c2213/wood-bridge/docs/design-exploration.md

# 形状探索 — ダビンチアーチを維持した CP 最大化

2026-10-21 実施。構造形式はダビンチアーチのまま変えず、CP = 最大荷重 / 自重^1.5 が最大になる構成を総当たりで探した。釣り糸と厚紙は、構造に効く場合だけ使う前提にした。
計算は [scripts/explore_davinci.py](../scripts/explore_davinci.py)。FEM・照査・材料値は [構造監査](structural-audit.md) と共通。

```sh
python3 scripts/explore_davinci.py            # 全探索（約 8 分）
python3 scripts/explore_davinci.py --refine   # 上位付近の絞り込み（約 1 分）
```

## 結論

**推奨案（下路・ダビンチ改良案）: CP 1.45、破壊荷重 約 292 N（30 kgf）、重量 約 34 g、荷重/自重 約 870 倍。**
現案（CP 0.10）の約 14 倍。

| 項目 | 現案 | 推奨案 |
| --- | --- | --- |
| 縦材 | 5mm角、各リブ A2列・B1列 | **4mm角**、各リブ A2列・B1列 |
| 横材 | 3mm角 | 3mm角 |
| 交差部 | 接着のみ（接着面 15 mm²） | **両側面に厚紙ガセット**（重ね 10 mm） |
| 床版縦桁（タイ） | 5mm角 | **5×15 縦使い** |
| ハンガー | 釣り糸ナイロン3号・全節点 | 同じ |
| 床版シート | 厚紙 t=0.5 | **なし**（ルール適合の確認が必要） |
| 支配する破壊（P） | 交差部の接着せん断（28 N） | 縦桁 292 N、面内座屈 350 N、めり込み 385 N がほぼ同じ水準 |

- **形の特徴:** 縦材が 4mm角になると δ = 3.5 mm、R = 349 mm になり、縦材長は 145.8 mm（150 mm まで余裕 4.2 mm）。現案の余裕 0.4 mm の問題も解消する。
- **床版シートを載せる場合:** ケント紙 t=0.2 で CP 1.12。

## 何が効いたか

| 変更 | 効果 | 理由 |
| --- | --- | --- |
| 交差部の厚紙ガセット | 破壊荷重が約 4〜9 倍 | 弱点だった木目直交の接着面（15 mm²）を、側面どうしの重ね接着で補える |
| 床版シートをなくす | 重量 −16 g | 荷重は横桁で受けられる。シートは構造的にほぼ働いていない |
| 縦桁を 5×15 縦使い | 破壊荷重が約 3 倍（重量は +8 g） | 補強後に次の弱点になった縦桁の曲げに効く |
| 縦材を 5 → 4mm角 | 軽量化、部材長の余裕が増える | 交差部を補強すると、縦材の断面に余力が出る |
| 釣り糸ハンガー（ナイロン） | バルサ 3mm角と同等以上 | 伸びやすい糸の方が、荷重が強い縦桁へ多く回る。重さはほぼ 0 |

**材料値の感度（推奨案）:**

| 振った材料値 | CP |
| --- | --- |
| 曲げ強度 13.5〜27 MPa | 0.94〜1.71 |
| 重ね接着のせん断 0.5〜2 MPa | 1.07〜1.45 |
| めり込み 0.4〜1.0 MPa | 1.28〜1.45 |
| ヤング率 2.1〜4.3 GPa | 1.24〜1.32 |

## 探索の範囲

全探索で、ルールに適合する 2,708 案を評価した。

| 項目 | 範囲 |
| --- | --- |
| 形式 | 下路（リブ2本＋吊り床版）、上路（アーチ上面を床版とする本来のダビンチ橋＋タイ） |
| 分割数 n | 8、10、12 |
| 縦材・横材 | 3角、4角、5角、5×15 平使い |
| 列数（A/B） | 1/1、2/1、1/2、2/2、3/3 |
| 交差部 | 接着のみ、厚紙ガセット |
| ハンガー | バルサ 3mm角、ナイロン3号（全節点、載荷点のみ） |
| 床版シート | なし、ケント紙 t=0.2 |
| タイ（上路） | 3角、5角 |

絞り込みでは、縦桁（タイ）の断面（4角、5角、5×15 縦使い）と、上路の荷重受け（5×15）を加えた。
ルールは「部材長 150 mm 以下」「有効幅 80 mm 以上」「床版上の有効高さ 80 mm」を自動で判定した。

**上路（本来のダビンチ橋）の最良:** CP 1.01（P 31 N、W 9.7 g）。非常に軽いが、載荷点の横材の曲げとタイで壊れ、下路の推奨案に届かなかった。床版が曲面になる点もルール上の確認が必要。

**形式の限界:** 同じ前提（床版シートなし）のプラットトラスは CP 約 3.2。ダビンチ形式を維持する場合、推奨案はトラスの約半分の CP になる。

## 厚紙なし条件での再探索（2026-10-21、ユーザー決定を受けて）

ユーザーの決定: 推奨案の方向で採用、床版シートなし、**厚紙は使わない**、材料試験は行わない。
推奨案の性能は交差部の厚紙ガセットに依存していたため、厚紙なしの条件で再探索した（`python3 scripts/explore_davinci.py --nocard`、約 2.5 分）。

- **評価した範囲:** 下路で 496 案（ルール適合）。
  - 分割数 8/10/12。
  - 縦材は 4角・5角・5×15 平使い、横材は 3〜5角・5×15 平使い。
  - 荷重が入る節点だけ横材を 5×15 平使いにする案も含めた。
  - 列数、ハンガー、縦桁 5角/5×15 も振った。
- **自立条件の判定:** 分割数と断面の組合せによっては、自立条件と支間 500 mm を同時に満たす R が存在しない。こうした構成を除外する判定を加えた。

**最良案（採用）: 分割数 10、縦材 4mm角、横材 5mm角、各リブ A1列/B1列、ナイロン3号ハンガーを載荷節点のみ、床版シートなし、縦桁 5×15 縦使い。**
CP 0.42、破壊荷重 約 59 N、重量 約 27 g、荷重/自重 約 220 倍。

| 比較 | CP |
| --- | --- |
| 旧案（ダビンチ、厚紙床版、交差部は接着のみ） | 0.08〜0.10 |
| **採用案（厚紙なし）** | **0.42** |
| 分割数 8 で最良の厚紙なし案 | 0.26 |
| 厚紙ガセットありの推奨案（不採用） | 1.45 |

- **分割数 10 が最良になる理由:** 交差部の接着面積（縦材の幅 × 横材の幅）を、部材長 150 mm 以下の範囲で最も大きくできる。横材 5mm角にでき、接着面は 20 mm²（分割数 8 の 3mm角では 12 mm²）。代わりにアーチが高くなる（クラウン約 21 cm）。
- **支配する破壊:** 交差接合の接着せん断で、最も弱い交差部は節点 T3・T7（x≈120・380）。次に弱いのは、荷重が入る T4・T6。
- **材料値の感度:**
  - 交差接合のせん断強度 0.4〜1.0 MPa で、CP 0.34〜0.84。接着の出来がそのまま性能に効く。
  - ヤング率 2.1〜4.3 GPa で、CP 0.38〜0.45。
  - めり込み強度と曲げ強度は、振っても CP が変わらなかった。

## 交差部の柔らかさを考慮した再評価（2026-10-21）

ユーザーから「59 N は低すぎるのでは」と指摘があり、モデルを見直した。

- **見直した点:** これまで、交差部（縦材と横材の接着）を無限に硬いとして扱っていた。実際には、横材の繊維直角方向はころがりせん断で柔らかい。剛として扱うと交差部に力が集まり、破壊荷重を過小に評価する。
- **新しいモデル:**
  - 交差部の接線方向の剛性はころがりせん断弾性係数（G_LT/10 ≈ 13 MPa）、法線方向は E90（0.046 E）から算定した。
  - 縦桁の横倒れ座屈（横桁の位置を横方向の支点とみなす簡易式）と、アーチ分担率（ハンガーがアーチへ運ぶ荷重の割合）を加えた。
  - 追加した選択肢: A系とB系を密着させ側面で交差点を接着する案、突き出し 3 mm（横材の半幅 +0.5 mm 以上に限る）。
- 実行: `python3 scripts/explore_davinci.py --nocard --soft`（約 15 分、ルール適合 2,192 案）。

**結果**

| 案 | P | W | CP | アーチ分担 | 支配する破壊 |
| --- | --- | --- | --- | --- | --- |
| 現行案（n=10、縦4角・横5角、A1/B1、ナイロン載荷点のみ、縦桁 5×15） | 111 N | 26.9 g | 0.80 | 25% | 縦桁の横倒れ座屈 |
| CP 最大: 現行案＋A–B 側面接着＋突き出し 3 mm | 117 N | 26.7 g | 0.85 | 28% | 縦桁の横倒れ座屈 |
| 全部 5mm 角（縦5角・横5角、A–B 側面接着、突き出し 3 mm） | 130 N | 31.6 g | 0.74 | 33% | 縦桁の横倒れ座屈 |
| アーチが主に運ぶ案の最良（全 5mm 角、縦桁 5×5、A1/B1、ナイロン載荷点のみ、突き出し 3 mm） | 62 N | 23.5 g | 0.54 | 90% | B系縦材の曲げ（曲げ 97%） |

**分かったこと**

- 剛として扱った旧評価（59 N）は控えめすぎた。現行案の推定は約 110〜120 N。
- **CP が高い案ほど、荷重の大部分を縦桁（5×15）が梁として運び、アーチの分担は 25〜33%。** 釣り糸ハンガーは伸びやすく、アーチより縦桁の方が硬いため。
- **アーチに主に荷重を運ばせると、CP は最大 0.54 にとどまる。** ダビンチの縦材は 3 点曲げで働くため、梁より効率が悪い。
- **全部 5mm 角にすると、破壊荷重は上がる（約 130 N）が、重くなるため CP は下がる（0.74）。** アーチ主体の案に限ると、全部 5mm 角が最良（CP 0.54）。

## 解析の自己点検と、床版なし・2点荷重向け補強の探索（2026-10-21）

ユーザーの指示: 床版なし。ダビンチの強みを活かしつつ、2点荷重に合う補強を探す。解析に不備がないかも点検する。

### 解析の自己点検（見つけた不備と対応）

| 不備 | 影響 | 対応 |
| --- | --- | --- |
| 交差部を無限に硬く扱っていた | 交差部に力が集まり、破壊荷重を約半分に過小評価 | ころがりせん断剛性と E90 から見積もった柔らかさを導入 |
| 自立条件と支間を同時に満たせない構成を通していた | 成立しないアーチ（R が下限に張り付く）を評価していた | 成立判定を追加して除外 |
| 監査スクリプトが図面の現行設計値を参照していた | 図面を更新すると旧案の監査結果が変わる | 監査対象の寸法を監査スクリプト側に固定 |
| 同系の縦材の端を、両方とも節点から突き出していた | 実物では同じ場所に置けない | 端を突き付ける（木口どうしのピン接合）選択肢を追加 |
| 縦桁の横倒れ座屈、アーチの面外座屈を照査していなかった | 細い部材の不安定を見落とす | 簡易式で照査を追加（概算） |

- **突き付け接合の効果:** 期待した強度向上は得られなかった（1 つの横材に力が集まる）。ただし中間の節点で突き出しが不要になり、部材長の制約が緩む。そのため分割数 8 で、縦材 3角・横材 5角 の組合せが成立するようになった。
- **荷重のかけ方の影響:** 同じアーチで比べると、破壊荷重は 2点 57 N、全節点に均等分散 68 N、中央1点 23 N。2点載荷はダビンチに不利だが、強さを抑えている主因は交差部と座屈。

### 探索（`python3 scripts/explore_davinci.py --reinforce`、ルール適合 1,350 案）

- **構成:** 床版なし。アーチ（ダビンチ）とタイだけで、錘はアーチの節点またはタイから吊る。
- **補強の候補:**
  - なし
  - 鉛直材（バルサ 3角）
  - ワーレン腹材（バルサ 3角、アーチ節点とタイをジグザグに結ぶ）
  - ニールセン（釣り糸の X 字）
- **振った項目:** 分割数、断面、列数、幅（詰め／90 mm）、タイ（3角・5角）とアンカー。

| 補強 | 最良 CP | P | W | 荷重/自重 |
| --- | --- | --- | --- | --- |
| **ワーレン腹材（錘はアーチ節点から）** | **1.73** | 43 N | 8.5 g | 約 510 倍 |
| ニールセン（釣り糸、錘はタイから） | 1.45 | 16 N | 5.0 g | 約 330 倍 |
| ワーレン腹材（錘はタイから） | 1.38 | 28 N | 7.4 g | 約 380 倍 |
| 補強なし | 0.96 | 19 N | 7.4 g | 約 270 倍 |
| 鉛直材 | 0.92 | 15 N | 6.5 g | 約 240 倍 |

**最良案:**

- 構成: 分割数 8、縦材 3mm角、横材 5mm角、A系 2列・B系 2列、同系の端は突き付け、タイ 3mm角、ワーレン腹材 3mm角（8 本、75〜136 mm）、幅を詰める（約 19 mm）。
- 形: クラウン高さ 125 mm、縦材長 147.6 mm。
- 支配する破壊: 交差部の接着せん断。次いで面外座屈 56 N、面内座屈 65 N。
- 補強の効果: 同じアーチで補強なしと比べると、破壊荷重は約 4 倍（10 → 43 N）、CP は約 3 倍（0.59 → 1.73）。腹材がアーチとタイを三角形でつなぎ、2点荷重による曲げ（形と荷重の不一致）を軸力で受け持つため。

**注意:**

- 幅を詰めた案（約 19 mm）は、横倒れの照査が概算しかない。幅 60 mm で CP 1.36、90 mm で 1.17。
- 錘を吊る節点 T3/T5 は x=179.1/320.9 で、載荷点 x=175/325 から 4 mm ずれる。
- 交差部の接着強度（ころがりせん断 0.5 MPa）が性能をほぼ決める。

### 採用（2026-10-21）

ユーザーの決定: 補強付きのこの案を採用、幅は詰める、床版なし。

- **腹材の配置を変更:** 図面化（3D 配置）で、腹材を中央の面に置くとアーチの縦材と干渉することが分かった。腹材をタイと同じ両側の 2 面（z=±9）に置き、横材を 22 mm に延ばした。
- **性能の再計算:** 腹材が 2 面になり重量が約 1.2 g 増えた。最終形は P 約 44 N、W 約 9.8 g、CP 1.41（探索時の 1 面の値は 1.73）。
- 詳細は [要件定義](requirements.md) を参照。

### ダビンチの編み構造は効いているか（2026-10-21 検証）

採用案で、アーチの編み構造（A・B 系を横材で編む）が強さに貢献しているかを確かめた。

| 比較（同じタイ・同じワーレン腹材 2 面・同じ載荷） | P | W | CP |
| --- | --- | --- | --- |
| 採用案（ダビンチの編み、3mm 角 A2/B2） | 44 N | 9.8 g | 1.41 |
| 上弦材を普通の折れ線アーチに替える（3mm 角 × 2 列、節点で連続） | 43 N | 6.8 g | 2.42 |
| 上弦材を普通の折れ線アーチに替える（3mm 角 × 4 列、節点で連続） | 85 N | 9.0 g | 3.18 |
| 採用案から腹材を除く（ダビンチのアーチだけ） | 10 N | 6.9 g | 0.57 |

- **荷重を主に受け持っているのは、タイと腹材によるトラスの働き。** 腹材を除くと破壊荷重は約 1/4 になる。
- **編み構造は弱点になっている。** アーチ縦材は曲げ応力が軸応力の約 3.7 倍で、最初に壊れるのも交差部の接着。同じ量の材料を普通の折れ線アーチ（連続材）に使うと、CP は約 2.3 倍になる。
- **ダビンチの本来の利点が、この課題では効きにくい。** ダビンチの利点は、留め具なしで短い材から長い支間を組めること。この課題では接着が許され、普通のアーチも短い材（節点間約 72 mm）を接着して組めるため、その利点が性能差にならない。
- **残る価値:** 見た目、コンセプト、オリジナリティ（プレゼンと相互評価の対象）。

## 確認が必要な事項（推奨案の時点）

1. **推奨案を採用して、図面（SVG/STL）と要件定義を更新するか。**
2. **床版シートなしでルールを満たすか**（担当教員に確認）。満たさない場合はケント紙 t=0.2 を使う（CP 1.12）。
3. **載荷点と横桁の位置:** 推奨案の横桁 C3 は x=180.8 で、載荷点 x=175 から 5.8 mm ずれる。シートがない場合、載荷治具は横桁の上に直接載るため、横桁を x=175 に置いて縦桁経由でハンガーへ渡す詳細にする。
4. **製作の手間:** 厚紙ガセットは交差部 54 か所 × 2 枚で、約 110 枚になる。
5. **未検証の項目:** 横倒れ（3D）は未解析。縦桁 5×15 の継手（添え板の重ね 30 mm、両面）も実物の試験が要る。
