c2213/wood-bridge/docs/structural-audit.md

# 構造監査 — ダビンチアーチ橋（下路式タイドアーチ）案

2026-10-21 実施。対象は [docs/requirements.md](requirements.md) のベース案（コミット `767f1c7`）。
計算は [scripts/audit_fem.py](../scripts/audit_fem.py)（`python3 scripts/audit_fem.py` で再現できる）。

## 結論

- **現案（ダビンチ）は CP で高得点を狙えない。** 推定の破壊荷重は約 22〜28 N（2.3〜2.8 kgf）、荷重/自重は約 50〜65 倍で、比較した形式の中で最も低い。
- **同じルール・同じ材料なら、下路式プラットトラスの CP が最も高い。** 現案の約 15 倍（CP 1.39 対 0.08）。次が通常の（編まない）タイドアーチ（CP 0.77）。
- **床版の軽量化が最も効く。** 厚紙 t=0.5（約 16 g）は総重量の約 4 割を占める。ケント紙 t=0.2 に替えると、どの形式でも CP が約 1.5 倍になる。
- **アンカーは不要。** 床版縦桁をタイにする方が強く、重さもほぼ同じ。タイを外してアンカーにすると、どの形式でも破壊荷重が大きく下がった。

CP = 最大荷重 / 自重^1.5 は実施要領 p.4 の式。表では P [N] / W [g]^1.5 で計算しており、形式間の比較だけに使う。

## 1. 評価方法

| # | 方法 | 何を見たか |
| --- | --- | --- |
| 1 | 手計算（アーチの釣合い） | 水平力 H = M/f。FEM の検算に使った |
| 2 | 2D フレーム FEM（線形） | 部材の軸力・曲げ、交差部の接触力、ハンガー・タイの張力、たわみ。圧縮になった釣り糸は外して再計算 |
| 3 | 線形座屈固有値解析 | 面内の全体座屈荷重（Sturm 列の二分法） |
| 4 | 部材・接合の照査 | 軸力＋曲げの組合せ、面外座屈（Euler）、交差部のめり込み・接着せん断、ガセット・継手、釣り糸の破断 |
| 5 | 形式比較 | ダビンチ（5通り）、通常タイドアーチ、プラットトラス（3断面）、アンカー案、床版4種 |
| 6 | 感度分析 | 接着強度、めり込み強度、ヤング率、圧縮強度を文献の幅で変化 |
| 7 | 文献・実績との照合 | ダビンチ橋の力学論文、同条件（スパン 500 mm、バルサ）の授業の実績 |

**FEM の検証:** 単純梁のたわみ、柱の座屈荷重、ピン結合の2部材の軸力の3例で、理論解と一致した（誤差 0.1% 未満）。現案のタイ張力は FEM で 0.696P、手計算 H = 87.5P/123.4 で 0.709P（差 2%）。

**材料値（代表値。実測していない）:** USDA Wood Handbook のバルサ（比重 0.16）を使った。

- バルサ: E 3.4 GPa、曲げ強度 21.6 MPa、圧縮 12 MPa（14.9 から低減）、引張 14 MPa、めり込み 0.6 MPa
- 接着: 交差接合（木目が直交する面）のせん断 0.5 MPa（ころがりせん断）、添え板の重ね接着 1.0 MPa
- 釣り糸: ナイロン3号は破断 53 N、結び目で 75% に低下。PE1号は破断 78 N、結び目で 40% に低下

**モデル化の前提:**

- 片側の1構面を 2D でモデル化し、全体荷重 P の半分を載せた。
- 荷重は載荷点に最も近い横桁へ、全量が伝わるとした。
- 自重は荷重に比べて小さいので無視した。

## 2. 現案（ダビンチ）の弱点

| 項目 | 値 |
| --- | --- |
| 支配する破壊 | 載荷点直上の節点 T3・T5 の交差接合。B系1本と横材の接着面 15 mm² が、0.34P のせん断を受ける |
| 縦材の応力 | **曲げ応力が軸応力の 6〜10 倍。** アーチなのに、ほぼ曲げで荷重を持っている |
| その他の破壊モード（破壊荷重） | 床版縦桁の曲げ 111〜221 N、面内座屈 327〜1059 N、ハンガー 204〜349 N |
| 総重量 | 約 44 g（リブ 15.4 g、厚紙床版 15.9 g、床版横桁 5.6 g、縦桁 4.1 g、接着剤の推定） |

- **形式そのものの弱点:** ダビンチ橋では、縦材の中央に隣の部材の端部が載る。そのため縦材は必ず3点曲げを受け、交差部には大きな接触力が生じる（Aummonier et al., 2025, *C. R. Mécanique* 353 と同じ結論）。紙模型の実験でも、荷重/自重は約 120 倍にとどまる（Técnica Industrial, 2021）。
- **改良しても届かない:** ハンガーの材料替え、同系の端部の剛結、交差部の接着強度を 2 倍にする、のいずれでも破壊荷重は最大約 44 N で、CP は 0.15 前後。トラスとの差は埋まらない。

## 3. 形式比較（床版は厚紙 t=0.5）

| 形式 | 総重量 W | 破壊荷重 P | 支配する破壊 | 荷重/自重 | CP |
| --- | --- | --- | --- | --- | --- |
| ダビンチ（ナイロン3号ハンガー、現案） | 44.2 g | 28 N | 交差接合のせん断 | 63 倍 | 0.09 |
| ダビンチ（バルサ3mmハンガー） | 44.2 g | 22 N | 交差接合のせん断 | 51 倍 | 0.08 |
| 通常タイドアーチ 5角×1本 | 32.2 g | 120 N | 床版縦桁の曲げ | 378 倍 | 0.65 |
| 通常タイドアーチ 5角×2本 | 36.8 g | 172 N | 床版縦桁の曲げ | 477 倍 | 0.77 |
| プラットトラス 弦5角・腹3角 | 35.3 g | 263 N | 斜材端部のガセット引張 | 760 倍 | 1.25 |
| **プラットトラス 弦5角・腹4角** | 37.4 g | 318 N | 端柱の面外座屈 | **867 倍** | **1.39** |
| プラットトラス 弦4角・腹3角 | 32.2 g | 130 N | 端柱の面外座屈 | 411 倍 | 0.71 |

**トラスの形状:** 高さ 90 mm（上弦材の下面は床版上 84.5 mm で、有効高さ 80 mm を確保）。パネルは 87.5 / 87.5 / 75 / 75 / 87.5 / 87.5 mm で、載荷点 x=175・325 を格点に合わせた。部材は最長 125.5 mm で、150 mm 以下。

**実績との照合:** 長崎大学の授業（バルサ 5 mm 材、スパン 500 mm、トラス）の実績は 795〜952 倍。プラットトラスの推定（760〜870 倍）はこれと同じ水準にある。

## 4. 床版・アンカー

**床版の重さを変えた場合（CP）**

| 床版 | ダビンチ | 通常タイドアーチ 5角×2本 | プラット 5/4 |
| --- | --- | --- | --- |
| 厚紙 t=0.5（15.9 g） | 0.08 | 0.77 | 1.39 |
| 厚紙 t=0.3（9.5 g） | 0.09 | 1.03 | 1.84 |
| ケント紙 t=0.2（6.4 g） | 0.11 | 1.21 | 2.16 |
| 床版なし（横桁のみ。ルール適合は要確認） | 0.15 | 1.81 | 3.19 |

**アンカー:** タイを外し、縦桁を 3mm 角にして水平力をスパン外のアンカーで受けると、次のように悪化した。

- ダビンチ: 22 → 16 N
- 通常タイドアーチ: 172 → 48 N

原因は2つ。縦桁は床版を支えるために結局必要で、タイを兼ねさせても重さはほとんど増えない。またアンカーにすると、縦桁の曲げと全体座屈が厳しくなる。下路式では、アンカーを使う利点はない。

## 5. CP = P/W^1.5 から言える設計方針

非構造の重量 W₀（床版・横桁・接着剤）を固定し、破壊荷重が構造重量 Ws に比例するとき、CP = k·Ws/(W₀+Ws)^1.5 は **Ws = 2·W₀** で最大になる。

- 現在のトラス案は W₀ ≈ 23 g、Ws ≈ 15 g で、最適より構造が軽い。腹材 3角 → 4角 で CP が上がったのはこのため。
- 床版を軽くして W₀ を下げると、最適な構造重量も下がる。全体を軽くする余地が広がる。
- 座屈で決まる部材では、破壊荷重が断面積のおおむね2乗で増える。部材を太くする方が有利。
- **優先順位: ① 床版の軽量化 → ② 座屈で決まる部材（端柱・上弦材）の補剛 → ③ 構造の余剰を削る。**

## 6. この監査で確認できていないこと

- **横倒れ（3D の全体座屈）は解析していない。** 長崎大学の実績でも主な破壊モードで、トラスの端柱、アーチのリブ端部が該当する。どの形式でも、端部の門構えと上横構が要る。
- **材料値はすべて文献の代表値。** めり込み強度と交差接合のせん断強度は推定値。実際に使うバルサ・釣り糸・接着の簡単な引張試験を勧める。
- **製作誤差・接着のばらつきは考慮していない。**
- **トラス・アーチの接合部:** 照査はガセット（厚紙の添え板、両面 15 mm 重ね）の引張だけ。圧縮側の端部の当たりは照査していない。

## 7. 判断が必要な事項

1. **構造形式:** ダビンチを続けるか、プラットトラス（または通常タイドアーチ）に切り替えるか。
2. **床版の材料と厚さ。** 床版なし（横桁と荷重受けだけ）がルール上認められるかを、担当教員に確認する。
3. **材料試験を行うか**（バルサ角材の引張・圧縮、接着の交差接合、釣り糸の結び目強度）。
