c2213/wood-bridge/MEMORY.md

# MEMORY

セッション開始時に読む作業記録。「セッション終了」時に、取り組んだこと／完了したこと／進行中のもの／決定事項／次回拾うべき項目を追記する。
