c2213/wood-bridge/work/bridge-draft.stl

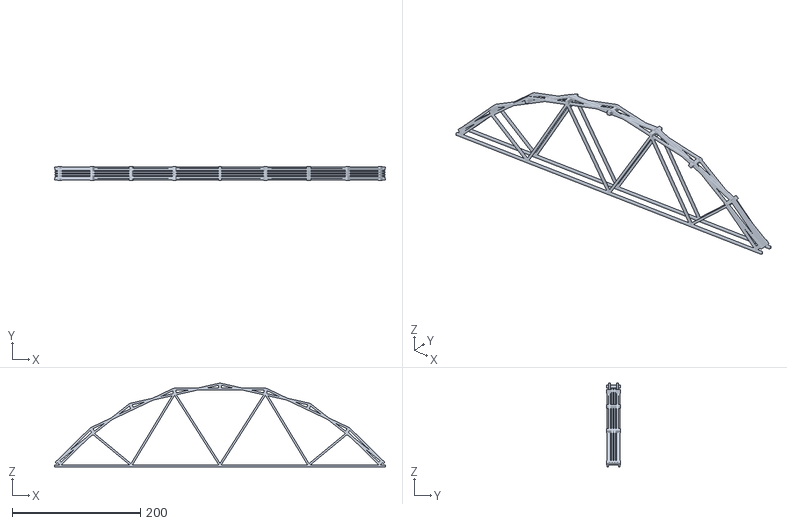
[picture p1: CAD file, 2026-10-21]
work/bridge-draft.stl
516.3 x 22.0 x 130.8
