c2213/wood-bridge/(commit log)

2026-10-21 ダビンチアーチ橋の要件定義と簡易図面SVG・確認用STLを追加
    [bridge-draft.stl]
2026-10-21 下路式タイドアーチに変更（上部床版を廃止、支点を線支持に対応）
    [bridge-draft.stl]
2026-10-21 構造監査（2D FEM・座屈・形式比較・CP評価）を追加
2026-10-21 ダビンチ維持の形状探索と推奨案を追加、作業後のpushを規則化
2026-10-21 厚紙なし条件で再探索し、採用案（n=10・縦材4角・横材5角・縦桁5×15）で図面と要件を更新
    [bridge-draft.stl]
2026-10-21 交差部の柔らかさ・縦桁の横倒れ座屈・アーチ分担率を考慮して再評価
2026-10-21 解析の不備を修正し、床版なし・2点荷重向け補強（ワーレン腹材等）を探索
2026-10-21 採用案（ダビンチアーチ＋ワーレン腹材・床版なし・幅詰め）で図面と要件を作り直し
    [bridge-draft.stl]
2026-10-21 ダビンチの編み構造の寄与を検証（普通の折れ線アーチとの比較）
